higherdefender/Vibes/Images/VibesPrototypes.png

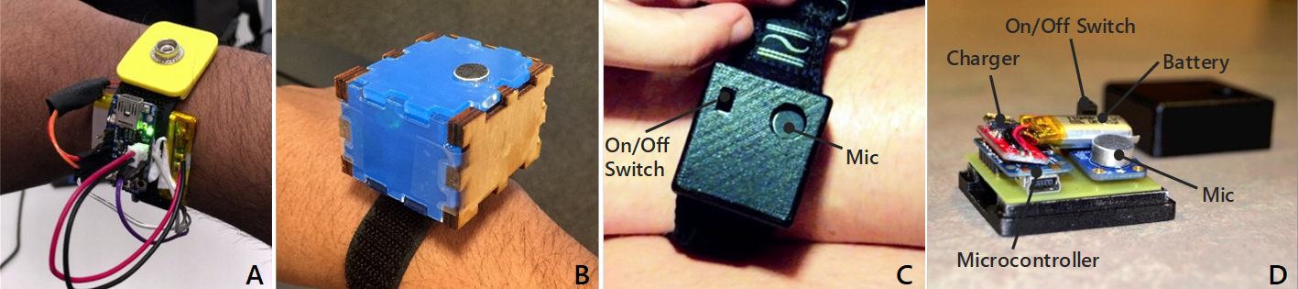
Images/VibesPrototypes.png
