higherdefender/Vibes/(list of files, drawings)

Other design files:
PCB/Vibes_PCB_v4.dip
